jonathonlui/MHO-C201/kicad/MHO-C201.kicad_pcb

## KiCad design KB16-01.sch

Schematic: KB16-01.sch

Parts:
C1, C2, C3, C4, C5, C6, C7, C10, C11, C12, C13, C14, C15, C16, C17, C18, C19, C20, C21, C22, C23, C24, C25: C
D1, D2, D3, D4, D5, D6, D7, D8, D9, D10, D11, D12, D13, D14, D15, D16, D17, D18, D19: D
EC1, EC2, EC3: Rotary_Encoder_Switch
J1: USB_C_Receptacle_USB2.0
J2, J3, J4: Conn_01x04
R1, R2, R3, R5, R6, R7, R8, R9, R10, R11, R12, R13, R14: R_US
RGB1, RGB2, RGB3, RGB4, RGB5, RGB6, RGB7, RGB8, RGB9, RGB10, RGB11, RGB12, RGB13, RGB14, RGB15, RGB16: SK6812; LED_SK6812_PLCC4_5.0x5.0mm_P3.2mm
S1: NRST
SW1, SW2, SW3, SW4, SW5, SW6, SW7, SW8, SW9, SW10, SW11, SW12, SW13, SW14, SW15, SW16: SW_Push
U1: STM32F103CBT6; LQFP-48_7x7mm_P0.5mm

Notes on the sheet:
I2C2_SCL
I2C2_SDA
BOOT1
USART1_TX
