jonathonlui/MHO-C201/(commit log)

2019-08-04 Add Kicad schematic
    [MHO-C201.kicad_pcb, MHO-C201.sch]
2019-08-04 Update schematic so it's more compact
    [MHO-C201.sch]
2019-09-02 Add notes about the display update process
    [MHO-C201.sch]
2019-09-22 Add description of rev eng process. Add sample logic analyzer capture
    Add basic README for the micropython lib
    [power-on.csv]
2019-09-23 Add example gif and post-wiring image
2024-10-18 Update README.md (#1)
    https://forum.kicad.info/t/warning-avoid-all-links-to-kicad-pcb-org-use-kicad-org/31521
